forgeVII/DIY-Rough-Gamepad/photos/README.md

# Photos

Place your gamepad photos here. Supported formats: .jpg, .jpeg, .png, .gif

Suggested photos:
- Front view (assembled)
- Back view / internal wiring
- Close-up of button mechanism
- Close-up of joystick modules
- Wiring overview
- In-use / action shot
- Damage / wear (showing it's been used heavily)
