forgeVII/DIY-Rough-Gamepad/(commit log)

2026-07-22 v1: DIY Rough Gamepad - 6 axis + 12 button USB HID HOTAS
    STM32F103C8T6 Blue Pill based handmade gamepad.
    - 6 analog axes via ADC (PS2 joystick modules)
    - 12 digital buttons with pull-up resistors
    - Raw USB HID, no drivers needed
    - Tested in: gamepad-tester.com, vJoy, Sniper Ghost Warrior 3, War Thunder, FlightGear
    MPU6050 gyro/accel attempted but I2C failed on STM32F103 - will be fixed in v2 with ESP32.
    [main.c]
2026-07-22 Remove HOTAS terminology - this is a reusable gamepad and test pad, not a throttle-and-stick
2026-07-22 Add photos and videos — design, electronics, gameplay testing, gamepad tester demo
2026-07-22 Add 2 photos + update README: internal pull-ups, cheap PS2 joystick drift calibration
2026-07-22 Update README: internal pull-ups, cheap PS2 joystick drift calibration
2026-07-22 Update README: honest build process — scrap wood, leftover paint, furniture tools
2026-07-22 Replace local videos with YouTube embeds — clickable thumbnails in README
2026-07-25 Add Arduino firmware variants with MPU6050 support
    - original: Full gamepad (MPU yaw/pitch/roll + 6 analog + combined trigger + yaw reset)
    - v2: Gyro-focused (no right stick X, separate triggers + yaw reset)
    - v3: Pots + buttons + roll/pitch on sliders, separate triggers
    - MPU6050 I2C issue resolved via Arduino Wire library
    - Update README with Arduino build instructions and variant table
    - Add MPU6050 video placeholders (Processing + in-game)
    [original.ino, v2.ino, v3.ino]
2026-07-25 Add calibration guide and yaw reset procedure to README
2026-07-25 Reset combo now resets all MPU axes (yaw + roll + pitch), not just yaw
    [original.ino, v2.ino]
