forgeVII/DIY-Rough-Gamepad/(notices)

Notices in the files:
README.md:
License: MIT
